elxecutor/nand2tetris-fpga/08_3D_Printer/rear_HX1K-Cube.stl

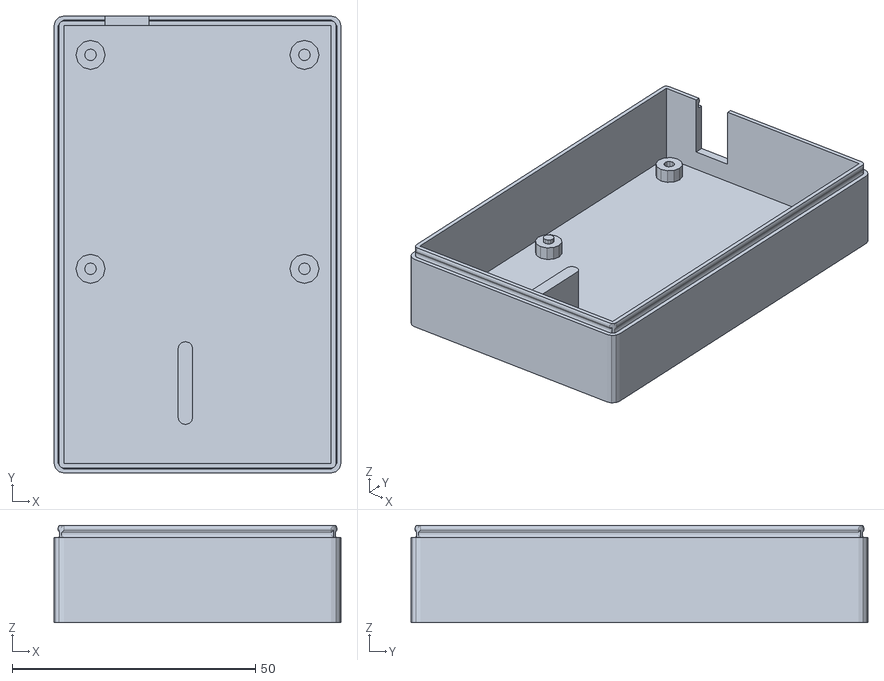
[picture p54: CAD file, 2026-08-10]
08_3D_Printer/rear_HX1K-Cube.stl
59.0 x 94.0 x 20.0
