elxecutor/nand2tetris-fpga/(list of files, cad)

Other CAD files:
08_3D_Printer/front_HX1K.blend
08_3D_Printer/nothing.blend
08_3D_Printer/rear_HX1K.blend
