elxecutor/nand2tetris-fpga/01_Boolean_Logic/Mux8Way16.v

/**
 * 16-bit multiplexor: 
 * for i = 0..15 out[i] = a[i] if sel == 0 
 *                        b[i] if sel == 1
 */

`default_nettype none
module Mux8Way16(
	input [15:0] a,
	input [15:0] b,
	input [15:0] c,
	input [15:0] d,
	input [15:0] e,
	input [15:0] f,
	input [15:0] g,
	input [15:0] h,
   	input [2:0] sel,
	output [15:0] out
);

	// Put your code here:
	wire [15:0] t1, t2;

	Mux4Way16 m1(a, b, c, d, sel[1:0], t1);
	Mux4Way16 m2(e, f, g, h, sel[1:0], t2);

	Mux16 m3(t1, t2, sel[2], out);

endmodule
