elxecutor/nand2tetris-fpga/01_Boolean_Logic/Not16.v

/**
 * 16-bit Not:
 * for i=0..15: out[i] = not in[i]
 */

`default_nettype none
module Not16(
	input [15:0] in,
	output [15:0] out
);

	// Put your code here:
	genvar i;
	generate
		for (i = 0; i <= 15; i++) begin
			Not U1(.in(in[i]), .out(out[i]));
		end
	endgenerate
endmodule
