elxecutor/nand2tetris-fpga/01_Boolean_Logic/Nand.v

/**
 * Nand gate: 
 * out = 0 if (a == 1 and b == 1)
 *       1 otherwise
 */

`default_nettype none
module Nand(
	input a,
	input b,
	output out
);

	// No need to implement this chip
	// This chip is implemented using verilog primitives
	nand(out, a, b);
endmodule
