elxecutor/nand2tetris-fpga/01_Boolean_Logic/04_Or/Include.v

`include "../../01_Boolean_Logic/Nand.v"
`include "../../01_Boolean_Logic/Not.v"
`include "../../01_Boolean_Logic/Buffer.v"
`include "../../01_Boolean_Logic/And.v"
`include "../../01_Boolean_Logic/Or.v"
