elxecutor/nand2tetris-fpga/01_Boolean_Logic/09_Buffer16/Include.v

`include "../../01_Boolean_Logic/Nand.v"
`include "../../01_Boolean_Logic/Not.v"
`include "../../01_Boolean_Logic/Buffer.v"
`include "../../01_Boolean_Logic/And.v"
`include "../../01_Boolean_Logic/Or.v"
`include "../../01_Boolean_Logic/Xor.v"
`include "../../01_Boolean_Logic/Mux.v"
`include "../../01_Boolean_Logic/DMux.v"
`include "../../01_Boolean_Logic/Not16.v"
`include "../../01_Boolean_Logic/Buffer16.v"
