elxecutor/nand2tetris-fpga/02_Boolean_Arithmetic/01_HalfAdder/HalfAdder_tb.v

`default_nettype none
module HalfAdder_tb();

	// IN,OUT
	reg a,b;
	wire sum,carry;

	// Part
	HalfAdder HALFADDER(
		.a(a),
		.b(b),
		.sum(sum),
		.carry(carry)
	);

	// Compare
	wire [1:0] out_cmp;
	assign out_cmp = a+b;
	
	reg fail = 0;
	task check;
		#1
		if ({carry,sum} != out_cmp) 
			begin
				$display("FAIL: a=%1b, b=%1b, sum=%1b, carry=%1b",a,b,sum,carry);
				fail=1;
			end
	endtask
	  
  	initial begin
  		$dumpfile("HalfAdder_tb.vcd");
  		$dumpvars(0, HalfAdder_tb);
		
		$display("------------------------");
		$display("Testbench: HalfAdder");
		
		a=0;b=0;check();
		a=0;b=1;check();
		a=1;b=0;check();
		a=1;b=1;check();
		
		if (fail==0) $display("passed");
		$display("------------------------");
		$finish;
	end

endmodule
