elxecutor/nand2tetris-fpga/02_Boolean_Arithmetic/FullAdder.v

/**
 * Computes the sum of three bits.
 */

`default_nettype none
module FullAdder(
	input a,		//1-bit input
	input b,		//1-bit input
	input c,		//1-bit input
	output sum,		//Right bit of a + b + c
	output carry	//Left bit of a + b + c
);

	// Put your code here:

endmodule
