elxecutor/nand2tetris-fpga/03_Sequential_Logic/BitShift8L.v

/**
* 8-bit Shiftregister (shifts to left)
* if      (load == 1)  out[t+1] = in[t]
* else if (shift == 1) out[t+1] = out[t]<<1 | inLSB
* (shift one position to left and insert inLSB as least significant bit)
*/

`default_nettype none
module BitShift8L(
	input clk,
	input [7:0] in,
	input inLSB,
	input load,
	input shift,
	output [7:0] out
);

	// Put your code here:

endmodule
