elxecutor/nand2tetris-fpga/03_Sequential_Logic/PC.v

/**
 * A 16-bit counter with load and reset control bits.
 * if      (reset[t] == 1) out[t+1] = 0
 * else if (load[t] == 1)  out[t+1] = in[t]
 * else if (inc[t] == 1)   out[t+1] = out[t] + 1  (integer addition)
 * else                    out[t+1] = out[t]
 */

`default_nettype none
module PC(
	input clk,
	input [15:0] in,
	input load,
	input inc,
	input reset,
	output [15:0] out
);	
	
	// Put your code here:

endmodule
