elxecutor/nand2tetris-fpga/06_IO_Devices/05_GO/boot.asm

//*****************************************************************************
// Boot loader. Load HACK code from SPI address 0x010000 (64k) into SRAM and GO
//*****************************************************************************
//
// Put your code here:
