elxecutor/nand2tetris-fpga/(commit log)

2026-08-17 Implement DMux with consistent wire naming
2026-08-17 Refactor wire names for consistency across gates
